M-F-Soares/5-CSRTT/Tela_Principal - Interface.jpg

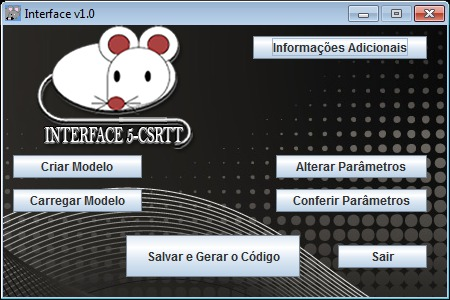
Tela_Principal - Interface.jpg
