M-F-Soares/5-CSRTT/Codex Atlanticus.JPG

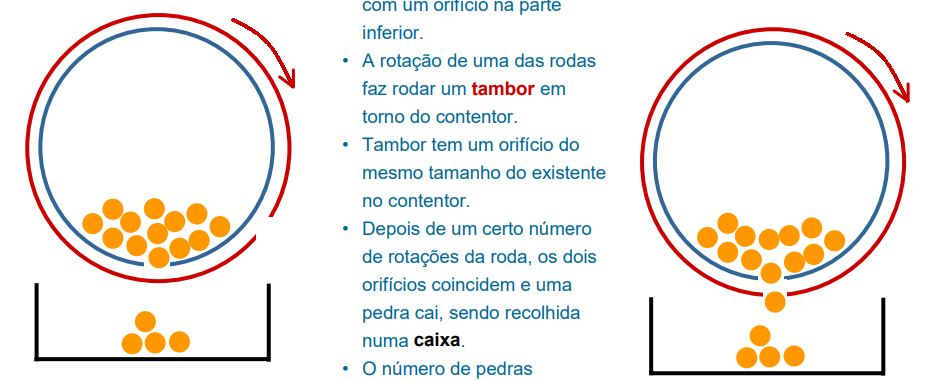
Codex Atlanticus.JPG
