M-F-Soares/5-CSRTT/5-choice essencial.pdf

# The application of the 5-choice serial reaction time task for the assessment of visual attentional processes and impulse control in rats

## Andrea Bari¹,2, Jeffrey W Dalley¹⁻³ & Trevor W Robbins¹,2

1Behavioural and Clinical Neuroscience Institute, University of Cambridge, Cambridge CB2 3EB, UK. 2Department of Experimental Psychology, University of Cambridge, Cambridge CB2 3EB, UK. 3Department of Psychiatry, University of Cambridge, Cambridge CB2 2QQ, UK. Correspondence should be addressed to T.W.R. (twr2@cam.ac.uk).

Published online 10 April 2008; doi:10.1038/nprot.2008.41

One popular way of measuring visual attentional processes in the rat is using 5-choice serial reaction time task (5-CSRTT). This paradigm requires subjects to detect brief flashes of light presented in a pseudorandom order in one of five spatial locations over a large number of trials. For this task, the animals are trained for B30–40 daily sessions during which they gradually learn to respond in the appropriate aperture within a certain amount of time. If they fail to respond, respond in the wrong hole or at an inappropriate time, a short period of darkness (time-out) is presented as punishment and no reward is delivered. The 5-CSRTT provides the possibility to test the effects of various neural, pharmacological and behavioral manipulations on discrete and somewhat independent measures of behavioral control, including accuracy of discrimination, impulsivity, perseverative responses and response latencies.

INTRODUCTION The 5-choice serial reaction time task (5-CSRTT) was initially developed to investigate and better understand the deficits shown by children with attention deficit/hyperactivity disorder (ADHD) at a preclinical level¹,2. The basic task is modeled after Leonard’s five-choice serial reaction task, which has been used to study human attentional processes³ and is considered to share many

components with the continuous performance test of attention⁴, also used in clinical settings.

The rat version of the task requires animals to detect brief flashes of light presented pseudorandomly in one of five holes and to make a nose-poke response in the correct spatial location in order to receive a food reward. To perform the task, the rat is required to monitor a horizontal array of apertures and to withhold from responding until the onset of the stimulus. Generally, the accuracy of stimulus discrimination provides an index of attentional capacity, while premature responses—made before the presentation of the stimulus—are regarded as a form of impulsive behavior and

hence a failure in impulse control¹.

### Attention is considered to be a heterogeneous construct in both

human and nonhuman subjects and the 5-CSRTT, in its basic form,

is well suited to assess animals’ deficits and/or improvements in sustained and spatially divided attention caused by pharmacological and neural manipulations. However, as we will see later, sensory and attentional demand of the basic task can be manipulated in several ways in order to characterize the neural and neurochemical substrates of attentional constructs under investigation¹,5. The 5-CSRTT has recently been used to assess trait impulsivity (in addition to attention) and this measure has been validated in part by its capacity to predict susceptibility to cocaine reinforcement⁶

and by its sensitivity to drugs used to treat human ADHD⁷⁻¹¹.

### The flexibility of the 5-CSRTT makes this task suitable for various testing purposes. For example, it is possible to test com-

pounds for the treatment of attentional deficits and impulsivity¹²;

### to assess attentional changes over the life span¹³,14 or those caused by chronic drug exposure¹⁵⁻¹⁷; to test the effects of discrete brain

lesions or neurotransmitter depletions¹⁸⁻²⁰; to select animals with specific patterns of behavior⁶,9 and to measure functional changes in neurotransmitter release or metabolic activity during the task (if coupled with the technique of in vivo microdialysis or 2-deoxyglucose autoradiography)²¹⁻²⁵. Moreover, the 5-CSRTT can be used to elucidate neuropsychological mechanisms that are disrupted in pathologies and states characterized by attentional dysfunctions such as childhood ADHD⁹, Alzheimer and Parkinson’s diseases²⁶,27, schizophrenia²⁸⁻³¹ and also aging¹³,14,32 and addiction¹⁵,16. The relationship with human research has been bidirectional, with animal work informing theories on the aetiology of human diseases and possible treatments, and human research

giving input to the design of preclinical investigations⁶,33–36.

The main strengths of the task are a high level of construct validity³⁷, a strict control over behavioral contingencies, accurate and automatized data acquisition and, due to its widespread use in many laboratories, it is of proven reliability. Some limitations are represented by the spatial and visual nature of the stimuli. Changes

in accuracy may reflect variations in visual sensory functions;

### however this problem can be addressed by varying the brightness of the visual discriminanda³⁸. In addition, the spatial component of

the task can be a confound in the interpretation of the results, but,

calculating the proportion of correct and incorrect responses made in each of the five spatial locations, it is possible to exclude subjects with a strong response bias¹⁹. Some other limitations are common to operant approaches in general. For example, it can be difficult to separate decrements in vigilance³⁹, which are typically evident toward the end of the session³⁷ (usually after an extended number of trials³²,40), from simple satiety due to the large number of pellets earned by the rat during the task. However, the latency to collect the

reward can help ruling out any decrement in motivation for food¹.

### On the other hand, food restriction itself constitutes a limitation to operant approaches and is a characteristic specific to research in animals. Prefeeding animals before testing is one approach that can be used to assess the effects of the general motivational state of the

animal on 5-CSRTT variables¹⁸,32.

### puor G

### gni hsil buP

### er ut a N8002 © natureprotocols / moc. er ut an. w

w
w//: ptt h
NATURE PROTOCOLS | VOL.3 NO.5 | 2008 | 759

# PROTOCOL

In summary, the 5-CSRTT has been used in a multitude of settings for a variety of research purposes, and this large amount of research has contributed substantially to our understanding of the neurobiological substrates and neurotransmitter systems underlying specific forms of attentional performance and behavioral

control¹,20,41–44.

### Most common applications of the paradigm Attentional processes are dysregulated in many psychiatric

disorders including ADHD⁴⁵, schizophrenia⁴⁶ and depression⁴⁷.

Optimal information processing in both humans and animals usually requires a mixture of sustained, divided and selective attention. Sustained attention (vigilance) is characterized by the continuous allocation of processing resources for the detection of rare events over an extended period of time⁴⁸. In the 5-CSRTT, long test sessions with high and low event rate (with short and long inter-trial interval (ITI), respectively) have previously been used to assess sustained visual attention⁴⁹. Moreover, the attentional load of the task can be manipulated by decreasing or increasing the

duration of the visual stimuli³².

The 5-CSRTT requires the animals to allocate their limited attentional resources on different sensory channels and spatial locations (spatially divided attention) in order to achieve an optimal level of performance. Moreover, as we will see later, one of the several modifications of the basic task structure allows to test also selective (focused) attention by interpolating irrelevant and distracting stimuli (most commonly in the auditory modality) during the ITI, while the animal has to attend to the occurrence of the target visual stimuli. In addition to attentional deficits, another symptom characteristic of ADHD and of many other psychiatric conditions is impulsivity, which is also a nonunitary construct⁵⁰ and can be defined as the tendency to act without foresight or before all the necessary information has been collected. The 5-CSRTT assesses the ability of the animal to wait for the occurrence of the visual stimulus and thus to withhold an impulsive response to one of the apertures. The flexibility of the task allows the experimenter to systematically manipulate the exact timing of

the occurrence of the stimuli so to make the waiting period short,

long or unpredictable⁵¹. The unpredictability of the stimuli makes the task more difficult because the animal cannot rely on automatic processes when orienting to the visual discriminanda, but has to continuously sustain response readiness¹ (see ANTICIPATED RESULTS for examples of results obtained after different task

manipulations).

Experimental design The protocol described in the following sections represents the most widely adopted task configuration implemented in the nine-hole box (see EQUIPMENT SETUP) in studies of attentional processes²,38. The nine-hole box can be configured for use in a wide range of applications such as delayed matching to position (‘working memory’), discrimination learning and cued target detection³⁸,52–54. Operant chambers equipped with only five aper-

tures are also available from various commercial vendors.

Here we will refer to the 5-CSRTT configuration of the apparatus, and relative parameter manipulations, that we use in our laboratory with adult Lister hooded rats. However, this protocol can also be used with different strains of rats after adjusting training length, baseline criteria and task parameters according to the visual capacity and cognitive skills of the animals³⁶. Slightly different

versions of the task exist for mice⁵⁵, monkeys⁵⁶,57 and humans¹³,35.

### Moreover, among the same strain of animals, the 5-CSRTT has been used to divide subjects according to good or bad performance based on parameters such as premature responses or choice

accuracy⁶,8,25,58.

In the most widely adopted version of the task (see Fig. 1), each post-training session begins with the illumination of the house light and of the food magazine where a ‘free’ food pellet is delivered. The rat initiates a trial by nose-poking in the food magazine to collect the pellet. Then, the light in the food magazine is extinguished and an ITI (standard: 5 s) starts during which the rat is required to sustain visual spatial attention (scanning behavior) to the five apertures present in the front panel of the operant chamber. At the end of the ITI, a brief visual stimulus (standard: 0.5 s) is presented in a random location and the animal is required to nose-poke in the hole where the stimulus appeared within a limited period (limited hold, LH; usually 5 s). The choice of the rat is detected by IR photocell beams located near the entrance of each aperture. A correct choice is rewarded with a food pellet delivered in the magazine (concurrently with its illumination) located in the opposite wall of the chamber, where an additional photocell beam

records the latency of food collection and starts the next ITI.

Response errors are represented by the number of omissions (i.e., failure to respond to the stimulus within the LH), errors of commission (i.e., responses made to the wrong location) and premature responses (i.e., responses made before the presentation of the visual stimulus in any of the five apertures; i.e., during the

### puor G

### gni hsil buP

### er ut a N8002 © natureprotocols / moc. er ut an. w

w
w//: ptt h

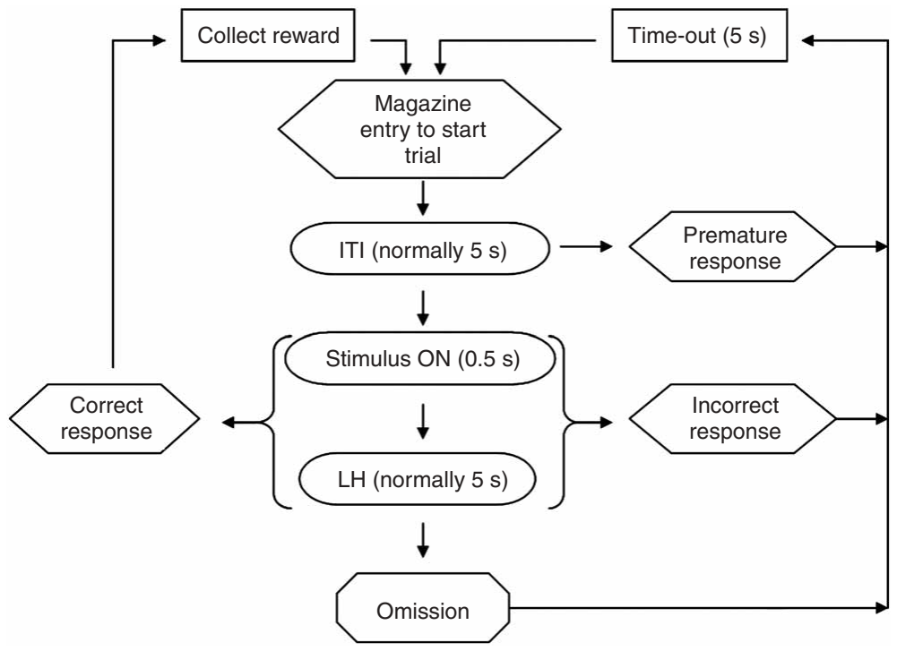
[picture p3: figure]
Collect reward; Time-out (5 s); Magazine entry to start trial; ITI (normally 5 s); Premature; response; Incorrect response; Stimulus ON (0.5 s); LH (normally 5 s); Omission; Correct response

Figure 1 | Possible trial sequences of the 5-choice serial reaction time task.
A trial is initiated by the rat entering the food magazine. A brief light stimulus is then presented in one of five possible apertures after a 5-s inter-trial interval (ITI) has elapsed. Rats are required to scan the five apertures for the appearance of the light stimulus and to respond in the ‘correct’ aperture with a nose-poke response in order to earn a single food pellet. If the rat responds before the stimulus (‘premature response’) or in an adjacent incorrect aperture (‘incorrect response’), a 5-s time-out (TO) period is introduced where the house light is extinguished and no food reward is provided. A failure to respond within the limited hold (LH) period results in an ‘omission’ and a subsequent 5-s TO period. After collecting the reward or—on punished trials—at the end of the TO period, a head entry in the food magazine starts a new trial.
760 | VOL.3 NO.5 | 2008 | NATURE PROTOCOLS

ITI). Inappropriate responses such as these are punished with a 5-s period of darkness (time-out, TO) during which no food is delivered and no action can be performed. TO periods are specifically used to suppress inappropriate behavior and thus signal to the animal the sequence of actions needed to obtain food reward. After a TO, the food magazine and the house light are illuminated and the rat has to nose-poke in the food magazine to

start a new trial.

Variables measured include both accuracy levels and response times (see DATA ANALYSIS). The accuracy in detecting the light stimulus and thus responding to the right locations is usually expressed as percentage of the total number of correct and incorrect responses, and does not include errors of omission or premature responses. Since the visual stimuli are presented the same number of times in each of the five apertures, the chance level of performance is 20%. However, further analysis can take into account also the spatial distribution of incorrect responses for each trial relatively to the correct location¹⁹,59. Additional responses in any of the five holes or in the food magazine are recorded as perseverative, which is often interpreted as a form of compulsive behavior¹. This parameter, together with the measure of premature responses (made during the ITI period), provides an index of

inhibitory response control. In previous experiments in our lab,

### perseverative responses resulted in a 5 s TO that was restarted every

### time the rat made a further response during the TO period (cumulative TO). However, we no longer punish perseverative responses

because of the significant disruptive effect this has on training.

To assess the speed of responding, three response times, or latencies, are usually measured. These are the mean latency to respond correctly (i.e., time elapsed between the onset of the stimulus and a response in the correct aperture), the mean latency of responses made in the wrong location, and the mean latency to collect the reward in the food magazine (i.e., the period between a

correct response and a head entry in the food magazine).

### Additionally, the latency of premature responses can be measured separately and the time distribution of correct, incorrect and premature responses can be analyzed further by dividing the LH

period into several time bins¹⁹.

### Response times in this task are valuable indices of the speed of information processing, readiness, decision making and general motivation of the animal. However, for a more accurate interpretation of these measures, it is useful to take into account the pattern

of changes in other variables¹.
Following the training schedule described in the later sections,

### animals generally reach a stable level of performance within 35 daily sessions. A good level of baseline performance is represented by accurate stimulus detection (i.e., 480% accuracy) and low levels of

omissions (i.e., o20%).

### MATERIALS

REAGENTS
.Rats (see REAGENT SETUP)
.Standard laboratory rodent food pellets (e.g., Purina Rat Chow)
.Food reward pellets (e.g., TestDiet 45 mg precision-weight, purified

ingredient rodent tablets; Sandown Scientific)
.Surface disinfectant for cleaning (e.g., Trigene or 70% ethanol solution) .Animal housing (see REAGENT SETUP)

EQUIPMENT
.Rat 9-hole (or 5-hole) operant chambers (e.g., Coulbourn Instruments,

Med Associates or other commercial suppliers; or custom-made 5-choice operant boxes)
.Sound-attenuating, fan-ventilated cubicles (large enough to enclose each

operant chamber and pellet dispenser)
.Dedicated computer software (see EQUIPMENT SETUP)
.Hardware to interface the operant boxes (interfacing hardware is generally

available from the suppliers of the operant boxes)
.Uninterruptible power supply (UPS)
.Data handling software (database for large amount of data; e.g.,

Microsoft Access)
.Data analysis software (e.g., SPSS)
.Medical gloves (e.g., nitrile or latex) and appropriate personal protection

equipment (e.g., lab coat and FFP2D type mask)
.Micro-camera connected to a closed circuit monitor (optional) .Controlling devices (see EQUIPMENT SETUP)

REAGENT SETUP
Rats Commercially available or laboratory-bred rats are commonly
used in the 5-CSRTT; although the task can be adapted for use in mice⁶⁰,61, the specific protocol and apparatus have been described elsewhere⁵⁵. In our laboratory we routinely use adult male Lister hooded rats, but the task is also suitable for use with adolescent⁶², aged¹⁴,40, female⁶³ or other strains of rats⁶⁴,65. ! CAUTION All experiments involving live animals must be approved by, and performed according to, national and institutional regulations.
Animal housing House rats in pairs or in groups of four per cage with sawdust on the bottom in a room maintained at a constant ambient temperature (20–24 1C) and humidity (55–70%). If the animals are purchased from a commercial vendor or have been shipped from any external location, they should be allowed to acclimatize to the new housing room for at least 7 d. During this period, provide food pellets and drinking water ad libitum and leave the animals undisturbed. In our laboratory we use a reverse light–dark cycle (lights on: 19:00 to 7:00 h) in order to test the rats during the most active period of their circadian cycle.
EQUIPMENT SETUP
Rat 9-hole (or 5-hole) operant chambers The 9- and 5-hole boxes present slightly different characteristics depending on the supplier and the actual model. The main features of the first models used in our laboratory have been described elsewhere². Usually the apparatus (25 25 25 cm³) consists of two aluminum walls, one of which is curved and equipped with 9 or 5 square holes of 2.5 cm sides, 4 cm deep and positioned 2 cm above the grid floor. The opposite aluminum wall is not curved and is equipped with a food well
(5 5 cm²) connected to a pellet dispenser (positioned outside the box) through a semi-transparent plastic tube. All the square holes and the food tray have IR beams crossing their entrance in order to detect the animals’ responses. The food tray and each hole are illuminated independently according to the task contingencies. The holes are usually numbered from 1 to 9 (or from 1 to 5) and they could be closed with metal or plastic caps, while the food tray may be fitted, in some models, with a plastic panel connected to a micro-switch that substitutes the IR beams in detecting head entries of the animal. The distance of the food tray is 25 cm for each hole on the curved wall
(see Fig. 2). Optionally, a loudspeaker could be fitted on the roof, or on the flat wall just below the house light (usually 3 W), which is the main source of illumination of the box during the task. The two side walls are made of clear polycarbonate or metal panels, one of which has a hinged door to allow the introduction of the animal. The floor is usually a metallic grid and the roof is made of clear polycarbonate or metal, sometimes with a small opening to allow the connection with external equipment (e.g., through perfusion tubing or electrical cables). Each box is accommodated within a sound-attenuating cubicle, which is ventilated by a fan that also provides a low background level of noise (see Fig. 3). Additionally, a micro-camera
could be mounted on the ceiling of the sound-attenuating cubicle in order to monitor rats’ behavior.
m CRITICAL Operant chambers should be cleaned and inspected regularly in order to avoid equipment malfunction and residue accumulation. Moreover, spare parts should be kept for each critical component of the apparatus (see TROUBLESHOOTING).
Controlling devices The task contingencies are usually controlled by a personal computer powered through an UPS device and connected to

### puor G

### gni hsil buP

### er ut a N8002 © natureprotocols / moc. er ut an. w

w
w//: ptt h

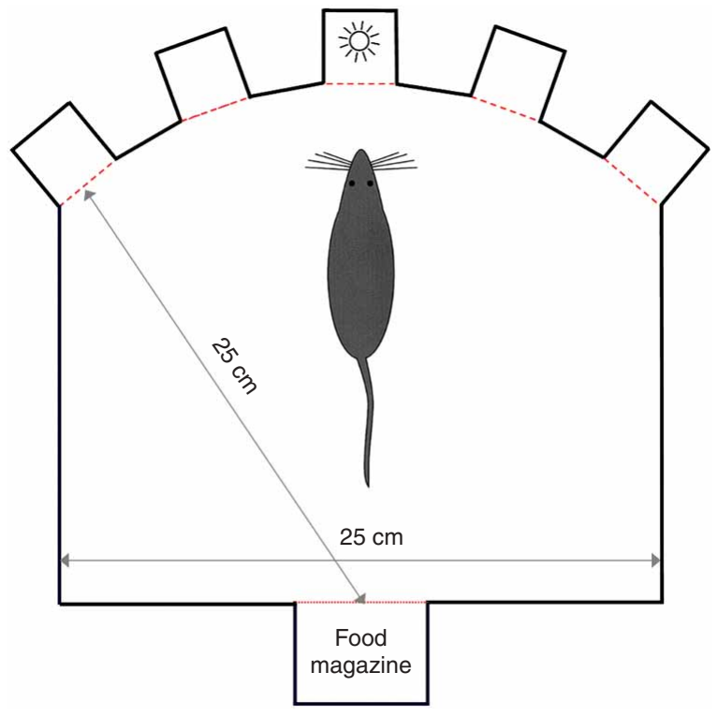
[picture p4: figure]
Food magazine

interfacing hardware through industry standard architecture (ISA) or peripheral component interface (PCI) slots. This hardware allows to interface the output and input data lines of the operant chambers to the personal computer. Although the interfacing hardware could be provided by the vendors of the operant chambers, digital input/output boards can also be purchased separately (e.g., Amplicon 272 series or Avantech 1753 cards). The operant chambers should be controlled by a computer having at least the minimum speed and memory requirements in order to present the stimuli and collect behavioral responses without any appreciable delay.
In our laboratory we use ‘Whisker server’⁶⁶ software to control inputs and outputs of the operant chambers. This software is commercially available and includes the 5-CSRTT client in its software suite. Alternative software to control the operant chambers can also be obtained from other sources (e.g., Med Associates, Campden Instruments, Lafayette Instruments), downloaded from the internet (e.g., http://www.mednr.com/programs/5csrtt.htm) or can be written using common programming languages.

## PROCEDURE Initial habituation 1| Gradually restrict (e.g., over 3 d) the daily amount of

food for each rat to B5 g of food per 100 g body weight.

## 2| Weigh each rat daily from the first day of food restriction

until they reach B85–90% of their free-feeding weight. Then,
weigh animals regularly (e.g., weekly) to monitor their growth.
! CAUTION Ensure that the body weight does not fall below 85% of the normal growth curve, which can usually be found on the website of the animals’ supplier. Alternatively, where appropriate, compare the weight of food-restricted animals with that of nonrestricted animals in order to determine precisely the extent of weight loss in individual animals.

3| Gradually habituate the animals to the experimenter over at least 3 d by gently handling each rat for 2–3 min d-

## 1, starting

on the first day of food restriction.
! CAUTION It is advisable to use disposable medical gloves always and to wear appropriate personal protection equipment when handling animals in order to minimize allergen-induced sensitization.

4| Every day, after handling, put some reward pellets (e.g., TestDiet 45 mg pellets) inside the cage (B30 per rat) to habituate the animals to their taste and to avoid hyponeophagia.

5| Devise a tail-marking system and assign a unique identification number to each animal. Use a nontoxic, odorless, permanent marker. Repeat this operation regularly to avoid fading of the marks. Although we prefer this method for identifying each animal, other techniques can also be used (e.g., ear tag, subcutaneous microchip).
m CRITICAL STEP Avoid marking the tail of the animal immediately before a critical experimental test session.

## Habituation to testing apparatus

6| Place ten reward pellets in the food tray and two pellets in each of the five apertures for each operant box.

7| Bring the rats to the testing room, assign each rat to a single operant box and start a short session (e.g., 15–20 min) during which all five stimulus lights, the house light and the tray light remain illuminated throughout the session. Repeat this step until the rats reliably eat all the pellets provided.

### puor G

### gni hsil buP

### er ut a N8002 © natureprotocols / moc. er ut an. w

w
w//: ptt h
Figure 2 | Schematic diagram of the 5-choice serial reaction time task
chamber showing the spatial arrangement of the five response apertures in relation to the food magazine. (Reprinted from ref. 72 with permission from Elsevier).

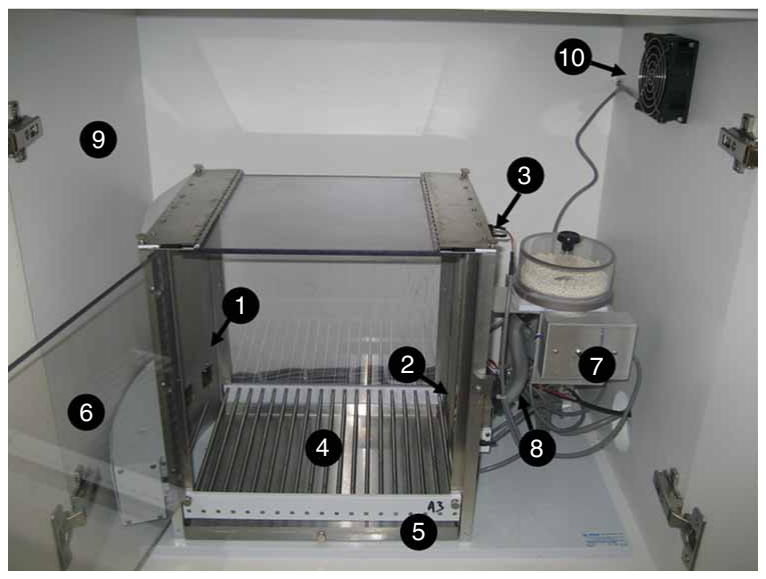
[picture p5: figure]

Figure 3 | Principal components of the 5-choice serial reaction time task
apparatus (commercial supplier: Med Associates, St. Albans, VT). On the front wall of the chamber (1) are five square holes equipped with IR detectors. IR photo beams are also present inside the food magazine (2) fitted on the opposite wall, where the house light is located (3). The floor of the chamber
(4) consists of stainless steel rods and at the bottom there is a removable tray (5). The hinged door (6) is generally made of transparent polycarbonate. The pellet dispenser (7) is located outside of the box and automatically delivers food pellet to the magazine through a plastic tube (8). The apparatus is enclosed within a sound-attenuating cubicle (9) fitted with an electric fan (10), which provides ventilation and low background noise.

m CRITICAL STEP Always adjust the amount of standard laboratory pellets you give daily to the rats subtracting the amount of reward pellets they eat during the session (e.g., for a B300-g rat: 15 g of standard pellets – (20 45 mg reward pellets) ¼ B14 g of standard pellets per rat after the training).
m CRITICAL STEP The time at which the animals are trained, tested and fed should be kept constant throughout
the experiment.

## 5-CSRTT training

8| Once the rats are habituated to the testing apparatus and to the reward pellets, start the 5-CSRTT training. No pellets should be placed in the holes or magazine during this phase of the training. Set up the software configuration for each box (see Experimental design and Fig. 1). Training sessions will generally comprise 100 trials and last B30 min. On each trial, only one hole is illuminated and the sequence is implemented by the computer software according to a pseudorandom schedule. In this way, each hole is illuminated 20 times during a 100 trials session. The appropriate initial parameters (see Table 1; stage 1) are: stimulus duration, 30 s; ITI, 2 s; LH, 30 s; TO, 5 s.

## Note: The majority of the rats begin to respond within four to

five sessions.

## m CRITICAL STEP Train and test the rats always in the same operant box because even a small change in the environment can

have deleterious effects on the training.

## 9| Once the animals reach a criterion of at least 30 correct trials, gradually decrease the stimulus duration and increase the ITI until the ‘target parameters’ are attained (see Table 1

and Supplementary Video 1 online).

10| To train the animals as described in Table 1 and to reach the ‘target parameters’, it usually requires B25 sessions during which the accuracy gradually increases. To achieve stable performance, train the animals for a further six to ten sessions until individual rats show reliably stable performance across days (Z80% accuracy and r20% of omissions). Depending on experimental objectives, animals that fail to achieve these criteria may be excluded as outliers or retained to assess important variations in the performance of poor-performer animals (e.g., premature responses, choice

accuracy)⁶,9,67.

## Post-training experimental manipulations

11| Once the performance is stable for at least six sessions,

use the data from the last 4 d of training to provide a baseline index of performance. Divide the subjects into two or more groups, matched for baseline performance, depending on the number of experimental manipulations (e.g., lesion sites, drug doses). Alternatively, animals may serve as their own controls, for example, using a within subjects design in pharmacological drug studies. Here it is important to control for the order of dosing using a randomized Latin

square design.

12| Depending on the aims of the experiment and the hypotheses under investigation, different manipulations of the basic task can be implemented during post-training sessions in order to vary task demands. We will describe the most commonly used variations of the basic task in which the standard settings are represented by the ‘target parameters’ of Table 1: short stimulus duration (option A); variable short and long ITI (option B); brightness of the visual signal (option C); and distracting noise (option D). These manipulations can be

### puor G

### gni hsil buP

### er ut a N8002 © natureprotocols / moc. er ut an. w

w
w//: ptt h
TABLE 1 | 5-CSRTT training schedule.

### Training stage

### Stimulus duration (s) ITI (s) LH (s)

### Criterion to move to next stage

1 | 30 | 2 | 30 | Z30 Correct trials
2 | 20 | 2 | 20 | Z30 Correct trials
3 | 10 | 5 | 10 | Z50 Correct trials
4 | 5 | 5 | 5 | Z50 Correct trials
| | | | 480% Accuracy
| | | | Z50 Correct trials
5 | 2.5 | 5 | 5 | 480% Accuracy
| | | | o20% Omissions
| | | | Z50 Correct trials
6 | 1.25 | 5 | 5 | 480% Accuracy
| | | | o20% Omissions
| | | | Z50 Correct trials
7 | 1 | 5 | 5 | 480% Accuracy
| | | | o20% Omissions
| | | | Z50 Correct trials
8 | 0.9 | 5 | 5 | 480% Accuracy
| | | | o20% Omissions
| | | | Z50 Correct trials
9 | 0.8 | 5 | 5 | 480% Accuracy
| | | | o20% Omissions
| | | | Z50 Correct trials
10 | 0.7 | 5 | 5 | 480% Accuracy
| | | | o20% Omissions
| | | | Z50 Correct trials
11 | 0.6 | 5 | 5 | 480% Accuracy
| | | | o20% Omissions
| | | | Z50 Correct trials
12 Target | 0.5 | 5 | 5 | 480% Accuracy
parameters | | | | o20% Omissions

Overview of the steps involved in training rats on the 5-choice serial reaction time task (5-CSRTT). Following habituation to the chamber, training proceeds via 12 distinct criterion-based stages. ITI, inter-trial interval; LH, limited hold.

made within a single ‘challenge’ session and/or repeated over several days. In this latter case, be sure to interpose ‘control’ sessions (usually one or two), with standard parameters, to enable the reattainment of stable performance³⁸. Moreover, although we will refer to commonly used methods for which relevant literature is available, optimal experimental design (e.g., within or between sessions design) is determined by the objectives and requirements of the specific experiment.

## (A) Short stimulus duration

(i) Set the stimulus duration to be shorter than the standard one (e.g., 0.25 or 0.125 s) and run a single session
for each rat⁵,68.
(ii) Alternatively, test a range of different stimulus lengths (e.g., 0, 0.01, 0.1, 0.2, 0.5 s) in a randomized order across sessions and subjects or within the same session¹³.
m CRITICAL STEP Since animals readily adapt to this manipulation, it is important to space repeated presentations
by at least 4 d.
m CRITICAL STEP It is possible in some circumstances to restore impaired performance by lengthening the stimulus duration. This procedure could be useful for bringing two experimental groups of subjects to similar levels of performance in order to assess the effects of other task manipulations against similar levels of accuracy⁶⁹,70.

## (B) Variable short and long ITI

(i) Within a single session, set a range of ‘short’ ITIs (e.g., four different values 0.5, 1.5, 3.0 and 4.5 s). Make sure to present each ITI length for the same number of trials for each spatial location²⁰.
(ii) After one or two baseline sessions, set a range of ‘long’ ITIs (e.g., 4.5, 6.0, 7.5, 9.0 s) and proceed as in Step 12B(i)¹⁸.
m CRITICAL STEP When using a long ITI challenge it is advisable to increase the maximum session duration (e.g., from 30 to 45 min) in order to allow sufficient time for subjects to complete all of the trials²⁰.

## (C)Brightness of the visual stimuli

(i) To check for differences in visual sensory functions between two experimental groups, set the intensity of the
visual stimuli to different levels of intensity (e.g., three different levels, all of which are fractions of the standard one). This manipulation is normally achieved by increasing the resistance in the electric circuit controlling the stimulus lights²,38,71.
(ii) Present each brightness condition within one session (including the standard stimulus intensity) keeping all the other parameters at standard values²,18.
m CRITICAL STEP Make sure that all of the five light stimuli have equal light intensities by measuring them with a commercially available instrument.
m CRITICAL STEP Increase the number of trials, if necessary, in order to present the different conditions an adequate number of times.

## (D) Distracting noise

(i) To assess the capacity of the animals to focus attentional processes toward the relevant stimuli, run a standard session interpolating brief bursts of white noise (0.5 s, 4100 dB) at various points within the normal ITI (e.g., 0.5, 2.5, 4.5, 5 s after the beginning of the ITI period)¹⁸,70.
(ii) Present the different conditions of the white noise the same number of times and in a randomized order for each spatial location.
m CRITICAL STEP In order to present each condition (delays) of the distracting stimuli for each spatial location for an adequate number of trials, it is advisable to increase the total number of trials in the session. Moreover, a certain number of control trials (in which no distracting noise is presented, e.g., 20% of trials) should be included².
m CRITICAL STEP Make sure that the distracting noise intensity is the same for each operant box measuring it with a commercially available device.
m CRITICAL STEP Avoid using this manipulation repeatedly because the animals will habituate to the distracting noise after repeated exposure.

## Data analysis 13| Record the following main behavioral variables for each subject on the 5-CSRTT:

Accuracy of discriminative performance, calculated as the number of correct responses divided by the total number of correct and incorrect responses expressed as a percentage.
Number of premature responses, defined as the number of anticipatory responses made before the onset of the visual stimulus in each session. In the most common version of the 5-CSRTT only one premature response is recorded on each trial.
Number of correct, incorrect and omitted trials in a session.
Latency to respond in a hole following the onset of the visual stimulus (for correct and incorrect responses separately).
Latency to collect food reward in the magazine following a correct response.
Number of repeat (or perseverative) nose-pokes either in the same hole as the target stimulus or in a different hole. Number of perseverative head entries in the magazine following food delivery.

### puor G

### gni hsil buP

### er ut a N8002 © natureprotocols / moc. er ut an. w

w
w//: ptt h

## ? TROUBLESHOOTING

## TIMING

## Steps 1–5, 5 min per rat per day: 5–6 d Steps 6 and 7, 25–30 min per rat per day: 1–2 d Steps 8–10, 20–40 min per rat per day: B30 d

## ? TROUBLESHOOTING

Troubleshooting advice can be found in Table 2. Some components of the operant chambers are more likely to fail after repeated use than others. It is good practice to have spare light bulbs, IR beams and pellet dispenser always available. Moreover, it is extremely important that regular checks are made on the operation of each test chamber. This should be done on a twice weekly basis to ensure that IR beams, light stimuli and the pellet dispensers are functioning reliably.

## ANTICIPATED RESULTS

Table 3 shows the effects of various behavioral manipulations on the baseline performance of a group of well-trained male Lister hooded rats on the 5-CSRTT (J.W.D., A.B. and T.W.R., unpublished data). It can be seen that reducing the stimulus duration from 0.5 to 0.125 s decreases the accuracy of responding by B20%. When the stimuli are made temporally, as well as

### puor G

### gni hsil buP

### er ut a N8002 © natureprotocols / moc. er ut an. w

w
w//: ptt h
TABLE 2 | Troubleshooting table.
Problem | Possible reason | Solution
Animal stops responding | Pellet dispenser may be jammed | Check the pellet dispenser and clean any blockage in the tube connecting the dispenser with the magazine
| Photo beam(s) failure | Clean photo beam(s) with a moistened cotton bud
| Light bulb(s) failure | Change faulty light bulb(s)
| Interface failure | Check for possible faulty line(s) in the input/output interface
Unstable performance or an abrupt decline in performance | Excessive satiety/hunger | Ensure that animals have been adequately fed
| | Feed animals after each training or test session at roughly the same time each day
Uneven performance across different operant boxes | Different intensity of the visual and/or acoustic stimuli | Titrate the intensity of visual and auditory stimuli to a uniform level
| Unreliable pellet delivery | Ensure that pellet dispensers are functioning reliably
Excessive perseverative responses | Photo beam(s) failure | Clean photo beams (as above)
Low discriminative accuracy | House light intensity too high | Replace the house light bulb
| Visual stimuli too dim | Increase the brightness of the visual stimuli
TABLE 3 | Expected baseline performance of adult male Lister hooded rats on the 5-choice serial reaction time task (n ¼ 9, mean ± s.e.m.).
| Baseline | Reduced SD | Var ITI | HER | White noise
Accuracy (%) | 80.7 ± 2.8 | 59.0 ± 3.1** | 79.4 ± 1.5 | 67.6 ± 2.0** | 86.3 ± 1.9
Omissions (number) | 5.8 ± 1.6 | 15.3 ± 4.7* | 11.9 ± 1.9** | 21.8 ± 2.8** | 7.1 ± 1.5
Response latency (ms) | 571 ± 41 | 598 ± 41 | 554 ± 31 | 863 ± 69** | 478 ± 23*
Premature responses | 6.6 ± 1.1 | 10.3 ± 1.4* | 32.4 ± 2.0** | 0.7 ± 0.4** | 15.5 ± 2.9*

HER, high event rate (inter-trial interval (ITI) ¼ 2 s); SD, stimulus duration; var, variable. *P o 0.05; **P o 0.01 (compared to baseline condition).

spatially, unpredictable (variable ITI 2, 4, 6 and 8 s) the main effect is to increase the number of premature responses. By contrast, when the target stimuli are presented with high frequency (high event rate; HER) over a large number of trials—in this case 200—detrimental effects on performance are normally observed, including a reduction in accuracy, an increase in omissions and a slowing of response latency. The number of premature responses also decreases under a HER manipulation. The presentation of a brief auditory stimulus (105 dB) during the ITI has the effect of increasing premature responding, especially when the auditory distractor is presented immediately prior to the onset of the visual target stimulus².

Note: Supplementary information is available via the HTML version of this article.

ACKNOWLEDGMENTS This research was supported by a Wellcome Trust programme grant (076274/z/04/z) and completed within the Cambridge University Behavioural and Clinical Neuroscience Institute, supported by a joint award from the Medical Research Council (MRC) and Wellcome Trust. A.B. was supported by an MRC studentship. The authors thank Dr Y. Pelloux and Mr D.E. Theobald for assistance.

COMPETING INTERESTS STATEMENT The authors declare competing financial interests (see the HTML version of this article for details).

Published online at http://www.natureprotocols.com
Reprints and permissions information is available online at http://npg.nature.com/reprintsandpermissions
1. Robbins, T.W. The 5-choice serial reaction time task: behavioural pharmacology and functional neurochemistry. Psychopharmacology (Berl.) 163, 362–380 (2002).
2. Carli, M., Robbins, T.W., Evenden, J.L. & Everitt, B.J. Effects of lesions to ascending noradrenergic neurones on performance of a 5-choice serial reaction task in rats; implications for theories of dorsal noradrenergic bundle function based on selective attention and arousal. Behav. Brain Res. 9, 361–380 (1983).
3. Wilkinson, R.T. Interaction of noise with knowledge of results and sleep deprivation. J. Exp. Psychol. 66, 332–337 (1963).
4. Beck, L.H., Bransome, E.D. Jr., Mirsky, A.F., Rosvold, H.E. & Sarason, I. A continuous performance test of brain damage. J. Consult. Psychol. 20, 343–350 (1956).
5. Hahn, B., Shoaib, M. & Stolerman, I.P. Nicotine-induced enhancement of attention in the five-choice serial reaction time task: the influence of task demands. Psychopharmacology (Berl.) 162, 129–137 (2002).
6. Dalley, J.W. et al. Nucleus accumbens D2/3 receptors predict trait impulsivity and cocaine reinforcement. Science 315, 1267–1270 (2007).
7. Navarra, R. et al. Effects of atomoxetine and methylphenidate on attention and impulsivity in the 5-choice serial reaction time test. Prog. Neuropsychopharmacol. Biol. Psychiatry 32, 34–41 (2008).
8. Blondeau, C. & Dellu-Hagedorn, F. Dimensional analysis of ADHD subtypes in rats. Biol. Psychiatry 61, 1340–1350 (2007).
9. Puumala, T. et al. Behavioral and pharmacological studies on the validation of a new animal model for attention deficit hyperactivity disorder. Neurobiol. Learn. Mem. 66, 198–211 (1996).
10. Bizarro, L., Patel, S., Murtagh, C. & Stolerman, I.P. Differential effects of psychomotor stimulants on attentional performance in rats: nicotine, amphetamine, caffeine and methylphenidate. Behav. Pharmacol. 15, 195–206 (2004).
11. Robinson, E.S. et al. Similar effects of the selective noradrenaline reuptake inhibitor atomoxetine on three distinct forms of impulsivity in the rat. Neuropsychopharmacology 33, 1028–1037 (2008).
12. Day, M. et al. Differential effects of ciproxifan and nicotine on impulsivity and attention measures in the 5-choice serial reaction time test. Biochem. Pharmacol. 73, 1123–1134 (2007).
13. Jones, D.N., Barnes, J.C., Kirkby, D.L. & Higgins, G.A. Age-associated impairments in a test of attention: evidence for involvement of cholinergic systems.
J. Neurosci. 15, 7282–7292 (1995).
14. Muir, J.L., Fischer, W. & Bjorklund, A. Decline in visual attention and spatial memory in aged rats. Neurobiol. Aging 20, 605–615 (1999).
15. Dalley, J.W. et al. Cognitive sequelae of intravenous amphetamine self-administration in rats: evidence for selective effects on attentional performance. Neuropsychopharmacology 30, 525–537 (2005).
16. Dalley, J.W. et al. Attentional and motivational deficits in rats withdrawn from intravenous self-administration of cocaine or heroin. Psychopharmacology (Berl.) 182, 579–587 (2005).
17. Dalley, J.W. et al. Enduring deficits in sustained visual attention during withdrawal of intravenous methylenedioxymethamphetamine self-administration in rats: results from a comparative study with d-amphetamine and methamphetamine. Neuropsychopharmacology 32, 1195–1206 (2007).
18. Harrison, A.A., Everitt, B.J. & Robbins, T.W. Central 5-HT depletion enhances impulsive responding without affecting the accuracy of attentional performance: interactions with dopaminergic mechanisms. Psychopharmacology (Berl.) 133, 329–342 (1997).
19. Passetti, F., Chudasama, Y. & Robbins, T.W. The frontal cortex of the rat and visual attentional performance: dissociable functions of distinct medial prefrontal subregions. Cereb. Cortex 12, 1254–1268 (2002).
20. Chudasama, Y. et al. Dissociable aspects of performance on the 5-choice serial reaction time task following lesions of the dorsal anterior cingulate, infralimbic and orbitofrontal cortex in the rat: differential effects on selectivity, impulsivity and compulsivity. Behav. Brain Res. 146, 105–119 (2003).
21. Winstanley, C.A., Theobald, D.E., Dalley, J.W., Cardinal, R.N. & Robbins, T.W. Double dissociation between serotonergic and dopaminergic modulation of medial prefrontal and orbitofrontal cortex during a test of impulsive choice. Cereb. Cortex 16, 106–114 (2006).
22. Dalley, J.W. et al. Distinct changes in cortical acetylcholine and noradrenaline efflux during contingent and noncontingent performance of a visual attentional task. J. Neurosci. 21, 4908–4914 (2001).
23. Passetti, F., Dalley, J.W., O’Connell, M.T., Everitt, B.J. & Robbins, T.W. Increased acetylcholine release in the rat medial prefrontal cortex during performance of a visual attentional task. Eur. J. Neurosci. 12, 3051–3058 (2000).
24. Dalley, J.W., Theobald, D.E., Pereira, E.A., Li, P.M. & Robbins, T.W. Specific abnormalities in serotonin release in the prefrontal cortex of isolation-reared rats measured during behavioural performance of a task assessing visuospatial attention and impulsivity. Psychopharmacology (Berl.) 164, 329–340
(2002).
25. Barbelivien, A., Ruotsalainen, S. & Sirvio, J. Metabolic alterations in the prefrontal and cingulate cortices are related to behavioral deficits in a rodent model of attention-deficit hyperactivity disorder. Cereb. Cortex 11, 1056–1063 (2001).
26. Carli, M., Evenden, J.L. & Robbins, T.W. Depletion of unilateral striatal dopamine impairs initiation of contralateral actions and not sensory attention. Nature 313, 679–682 (1985).
27. Muir, J.L., Dunnett, S.B., Robbins, T.W. & Everitt, B.J. Attentional functions of the forebrain cholinergic systems: effects of intraventricular hemicholinium, physostigmine, basal forebrain lesions and intracortical grafts on a multiplechoice serial reaction time task. Exp. Brain Res. 89, 611–622 (1992).
28. Chudasama, Y. & Robbins, T.W. Psychopharmacological approaches to modulating attention in the five-choice serial reaction time task: implications for schizophrenia. Psychopharmacology (Berl.) 174, 86–98 (2004).
29. Amitai, N., Semenova, S. & Markou, A. Cognitive-disruptive effects of the psychotomimetic phencyclidine and attenuation by atypical antipsychotic medications in rats. Psychopharmacology (Berl.) 193, 521–537 (2007).
30. Le Pen, G., Grottick, A.J., Higgins, G.A. & Moreau, J.L. Phencyclidine exacerbates attentional deficits in a neurodevelopmental rat model of schizophrenia. Neuropsychopharmacology 28, 1799–1809 (2003).
31. Baviera, M., Invernizzi, R.W. & Carli, M. Haloperidol and clozapine have dissociable effects in a model of attentional performance deficits induced by blockade of NMDA receptors in the mPFC. Psychopharmacology (Berl.) 196, 269–280 (2007).
32. Grottick, A.J. & Higgins, G.A. Assessing a vigilance decrement in aged rats: effects of pre-feeding, task manipulation, and psychostimulants. Psychopharmacology (Berl.) 164, 33–41 (2002).
33. Winstanley, C.A., Eagle, D.M. & Robbins, T.W. Behavioural models of impulsivity in relation to ADHD: translation between clinical and preclinical studies. Clin. Psychol. Rev. 26, 379–395 (2006).
34. Chudasama, Y. & Robbins, T.W. Functions of frontostriatal systems in cognition: comparative neuropsychopharmacological studies in rats, monkeys and humans. Biol. Psychol. 73, 19–38 (2006).

### puor G

### gni hsil buP

### er ut a N8002 © natureprotocols / moc. er ut an. w

w
w//: ptt h

35. Sahakian, B.J. et al. Further analysis of the cognitive effects of tetrahydroaminoacridine (THA) in Alzheimer’s disease: assessment of attentional and mnemonic function using CANTAB. Psychopharmacology (Berl.) 110, 395–401 (1993).
36. Paine, T.A., Tomasiewicz, H.C., Zhang, K. & Carlezon, W.A. Jr. Sensitivity of the five-choice serial reaction time task to the effects of various psychotropic drugs in Sprague-Dawley rats. Biol. Psychiatry 62, 687–693 (2007).
37. Mirza, N.R. & Stolerman, I.P. Nicotine enhances sustained attention in the rat under specific task conditions. Psychopharmacology (Berl.) 138, 266–274 (1998).
38. Robbins, T.W., Muir, J.L., Killcross, A.S. & Pretsell, D. Methods for assessing attention and stimulus control in the rat. In Behavioural Neuroscience: A Practical Approach Vol. I (ed. Sahgal, A.) 13–40 (Oxford University Press, New York, 1993).
39. Parasuraman, R. & Mouloua, M. Interaction of signal discriminability and task type in vigilance decrement. Percept. Psychophys. 41, 17–22 (1987).
40. Grottick, A.J., Haman, M., Wyler, R. & Higgins, G.A. Reversal of a vigilance decrement in the aged rat by subtype-selective nicotinic ligands. Neuropsychopharmacology 28, 880–887 (2003).
41. Robbins, T.W. & Everitt, B.J. Arousal systems and attention. In The Cognitive Neurosciences (ed. Gazzaniga, M.S.) 703–720 (MIT Press, Cambridge, Massachusetts, 1995).
42. Chudasama, Y., Baunez, C. & Robbins, T.W. Functional disconnection of the medial prefrontal cortex and subthalamic nucleus in attentional performance: evidence for corticosubthalamic interaction. J. Neurosci. 23, 5477–5485 (2003).
43. Passetti, F., Dalley, J.W. & Robbins, T.W. Double dissociation of serotonergic and dopaminergic mechanisms on attentional performance using a rodent five-choice reaction time task. Psychopharmacology (Berl.) 165, 136–145 (2003).
44. Bushnell, P.J. Behavioral approaches to the assessment of attention in animals. Psychopharmacology (Berl.) 138, 231–259 (1998).
45. Biederman, J. Attention-deficit/hyperactivity disorder: a selective overview. Biol. Psychiatry 57, 1215–1220 (2005).
46. Laurent, A. et al. Attentional deficits in patients with schizophrenia and in their non-psychotic first-degree relatives. Psychiatry Res. 89, 147–159 (1999).
47. Brown, R.G., Scott, L.C., Bench, C.J. & Dolan, R.J. Cognitive function in depression: its relationship to the presence and severity of intellectual decline. Psychol. Med. 24, 829–847 (1994).
48. Parasuraman, R., Warm, J.S. & See, J.E. Brain systems and vigilance. In The Attentive Brain (ed. Parasuraman, R.) 221–256 (MIT Press, Cambridge, Massachusetts, 1998).
49. Dalley, J.W. et al. Cortical cholinergic function and deficits in visual attentional performance in rats following 192 IgG-saporin-induced lesions of the medial prefrontal cortex. Cereb. Cortex 14, 922–932 (2004).
50. Evenden, J.L. Varieties of impulsivity. Psychopharmacology (Berl.) 146, 348–361 (1999).
51. Christakou, A., Robbins, T.W. & Everitt, B.J. Prefrontal cortical-ventral striatal interactions involved in affective modulation of attentional performance: implications for corticostriatal circuit function. J. Neurosci. 24, 773–780 (2004).
52. Rosner, A.L. & Mittleman, G. Visuospatial attention in the rat and posterior parietal cortex lesions. Behav. Brain Res. 79, 69–77 (1996).
53. Ward, N.M. & Brown, V.J. Covert orienting of attention in the rat and the role of striatal dopamine. J. Neurosci. 16, 3082–3088 (1996).
54. Chudasama, Y. & Robbins, T.W. Dopaminergic modulation of visual attention and working memory in the rodent prefrontal cortex. Neuropsychopharmacology 29, 1628–1636 (2004).
55. Humby, T., Wilkinson, L.S. & Dawson, G.R. Assaying aspects of attention and impulse control in mice using the 5-choice serial reaction time task. In Current

Protocols in Neuroscience (eds. Gerfen, C., Holmes, A., Rogawski, M., Sibley, D., Skolnick, P. & Wray, S.) Unit 8.5H, 8.5H.1–8.5H.15, supplement 31 (John Wiley & Sons, Hoboken, New Jersey, 2005).
56. Weed, M.R. et al. Performance norms for a rhesus monkey neuropsychological testing battery: acquisition and long-term performance. Brain Res. Cogn. Brain Res. 8, 185–201 (1999).
57. Spinelli, S. et al. Performance of the marmoset monkey on computerized tasks of attention and working memory. Brain Res. Cogn. Brain Res. 19, 123–137 (2004).
58. Diergaarde, L. et al. Impulsive choice and impulsive action predict vulnerability to distinct stages of nicotine seeking in rats. Biol. Psychiatry 63, 301–308 (2008).
59. Blondel, A., Sanger, D.J. & Moser, P.C. Characterisation of the effects of nicotine in the five-choice serial reaction time task in rats: antagonist studies. Psychopharmacology (Berl.) 149, 293–305 (2000).
60. Lambourne, S.L. et al. Impairments in impulse control in mice transgenic for the human FTDP-17 tauV337M mutation are exacerbated by age. Hum. Mol. Genet. 16, 1708–1719 (2007).
61. Davies, W., Humby, T., Isles, A.R., Burgoyne, P.S. & Wilkinson, L.S. X-monosomy effects on visuospatial attention in mice: a candidate gene and implications for Turner syndrome and attention deficit hyperactivity disorder. Biol. Psychiatry 61, 1351–1360 (2007).
62. de Senerpont Domis, L.M., Theobald, D.E., Verster, J.C., Dalley, J.W. & Robbins, T.W. Modelling impulsivity in adolescent rats. In Abstract Supplement to Journal of Psychopharmachology (ed. Dursun, S.) Vol. 21 A47 (Summer Meeting of the British Association for Psychopharmachology, Harrogate, UK, 2007).
63. Barnes, P., Staal, V., Muir, J. & Good, M.A. 17-Beta estradiol administration attenuates deficits in sustained and divided attention in young
ovariectomized rats and aged acyclic female rats. Behav. Neurosci. 120, 1225–1234 (2006).
64. Mirza, N.R. & Bright, J.L. Nicotine-induced enhancements in the five-choice serial reaction time task in rats are strain-dependent. Psychopharmacology (Berl.) 154, 8–12 (2001).
65. De Bruin, N.M., Kiliaan, A.J., De Wilde, M.C. & Broersen, L.M. Combined uridine and choline administration improves cognitive deficits in spontaneously hypertensive rats. Neurobiol. Learn. Mem. 80, 63–79 (2003).
66. Cardinal, R.N. & Aitken, M.R.F. Whisker, version 2.2, computer software http://www.whiskercontrol.com (2001).
67. Granon, S. et al. Enhanced and impaired attentional performance after infusion of D1 dopaminergic receptor agents into rat prefrontal cortex. J. Neurosci. 20, 1208–1215 (2000).
68. Winstanley, C.A. et al. Intra-prefrontal 8-OH-DPAT and M100907 improve visuospatial attention and decrease impulsivity on the five-choice serial reaction time task in rats. Psychopharmacology (Berl.) 167, 304–314 (2003).
69. Robbins, T.W. et al. Comparative effects of ibotenic acid- and quisqualic acidinduced lesions of the substantia innominata on attentional function in the rat: further implications for the role of the cholinergic neurons of the nucleus basalis in cognitive processes. Behav. Brain Res. 35, 221–240 (1989).
70. Muir, J.L., Everitt, B.J. & Robbins, T.W. AMPA-induced excitotoxic lesions of the basal forebrain: a significant role for the cortical cholinergic system in attentional function. J. Neurosci. 14, 2313–2326 (1994).
71. Cole, B.J. & Robbins, T.W. Forebrain norepinephrine: role in controlled information processing in the rat. Neuropsychopharmacology 7, 129–142 (1992).
72. Dalley, J.W., Cardinal, R.N. & Robbins, T.W. Prefrontal executive and cognitive functions in rodents: neural and neurochemical substrates. Neurosci. Biobehav. Rev. 28, 771–784.

### puor G

### gni hsil buP

### er ut a N8002 © natureprotocols / moc. er ut an. w

w
w//: ptt h
