M-F-Soares/5-CSRTT/PCB/placa_casinhas.pdf

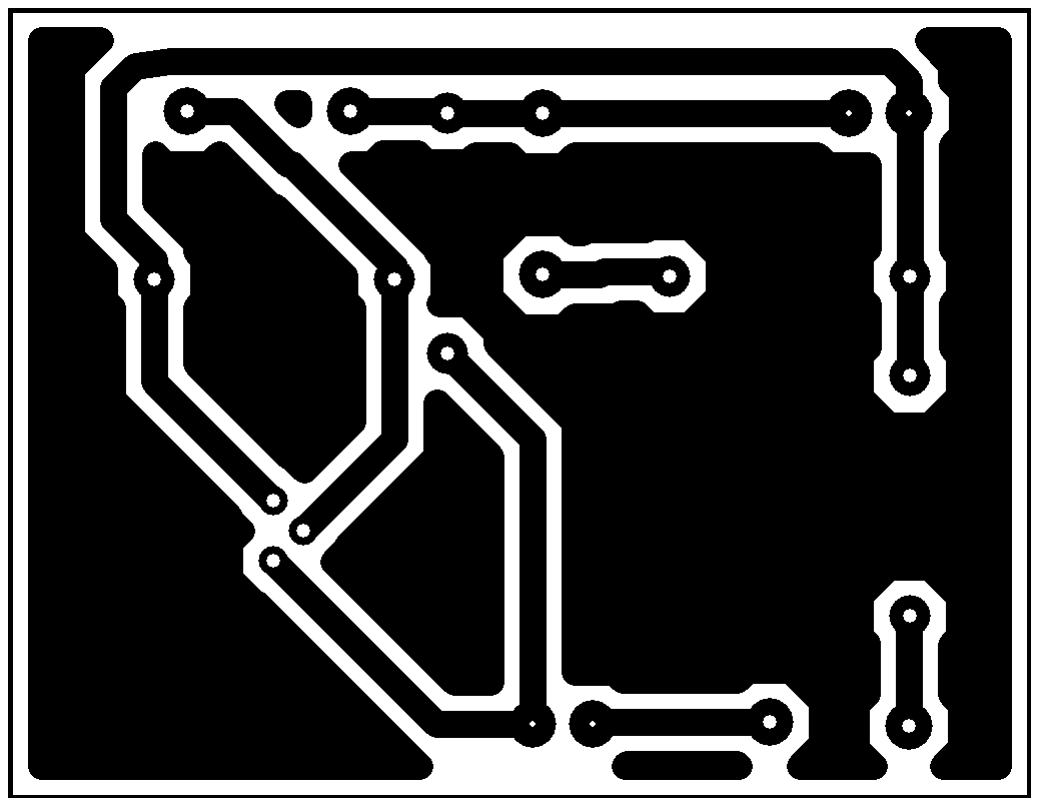
[picture p9: figure]
