M-F-Soares/5-CSRTT/PCB/casinhas.bmp

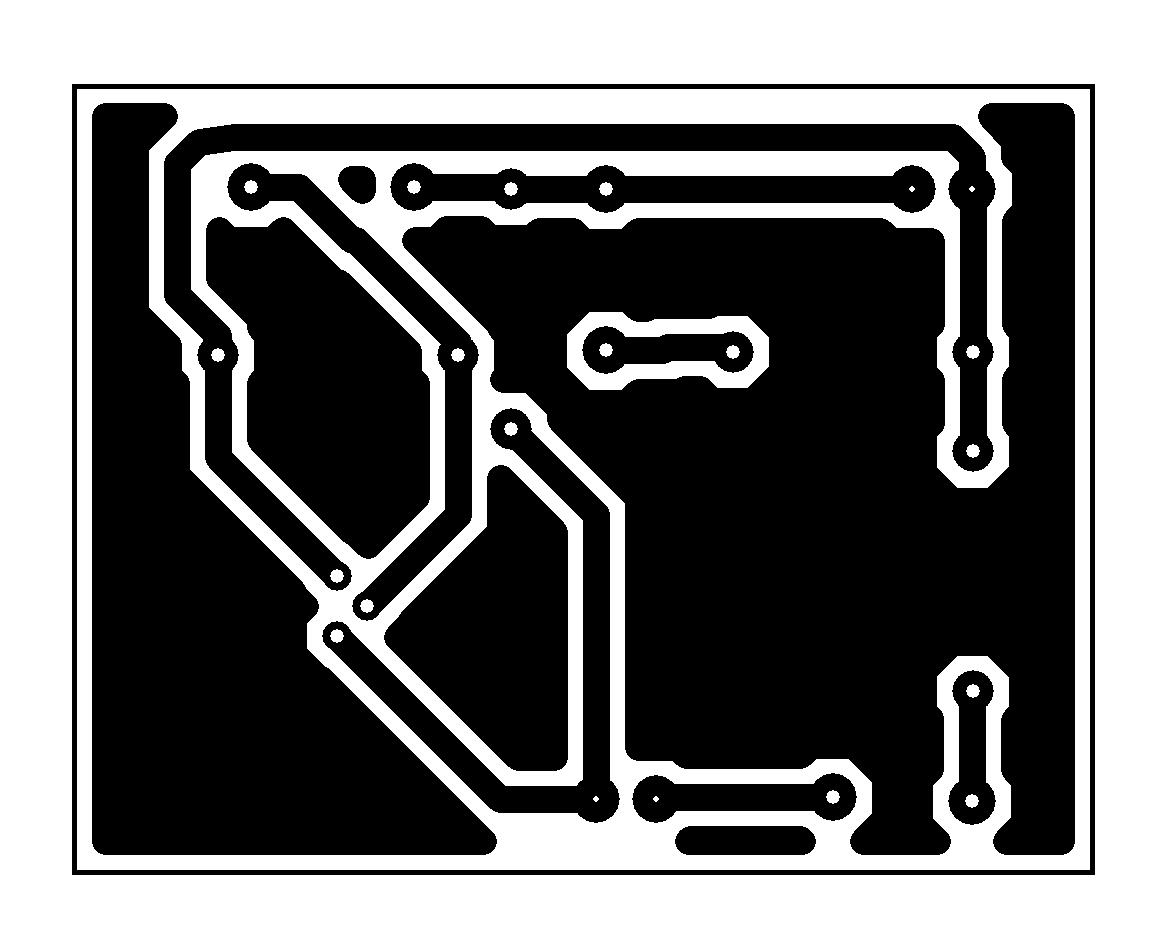
PCB/casinhas.bmp
