M-F-Soares/5-CSRTT/Desenhos/Alimentador/caixa.SLDPRT

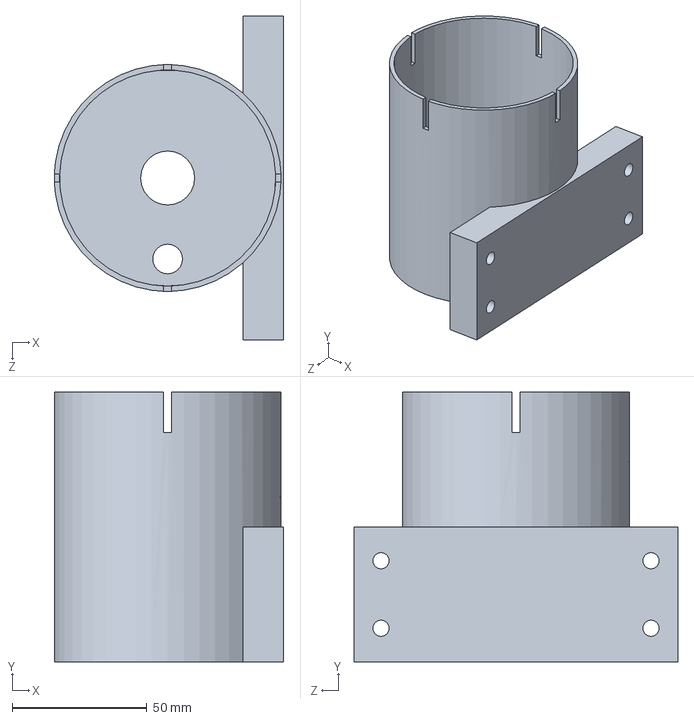
[picture p11: CAD file, 2021-06-11]
Desenhos/Alimentador/caixa.SLDPRT
85.0 x 100.0 x 120.0 mm
