M-F-Soares/5-CSRTT/Desenhos/Alimentador/Disco1.SLDPRT

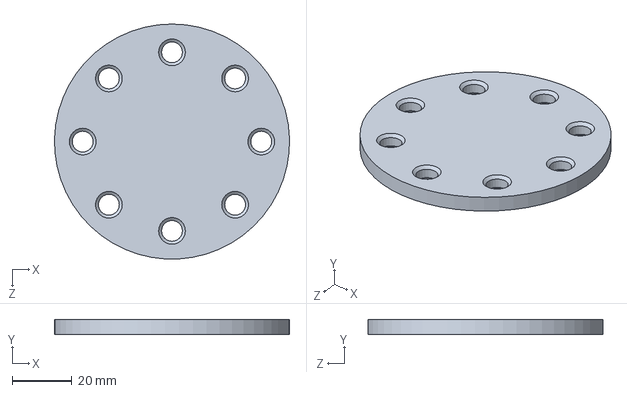
[picture p12: CAD file, 2021-06-11]
Desenhos/Alimentador/Disco1.SLDPRT
79.0 x 5.00 x 78.9 mm
