M-F-Soares/5-CSRTT/Desenhos/Alimentador/camara_alimentador.SLDPRT

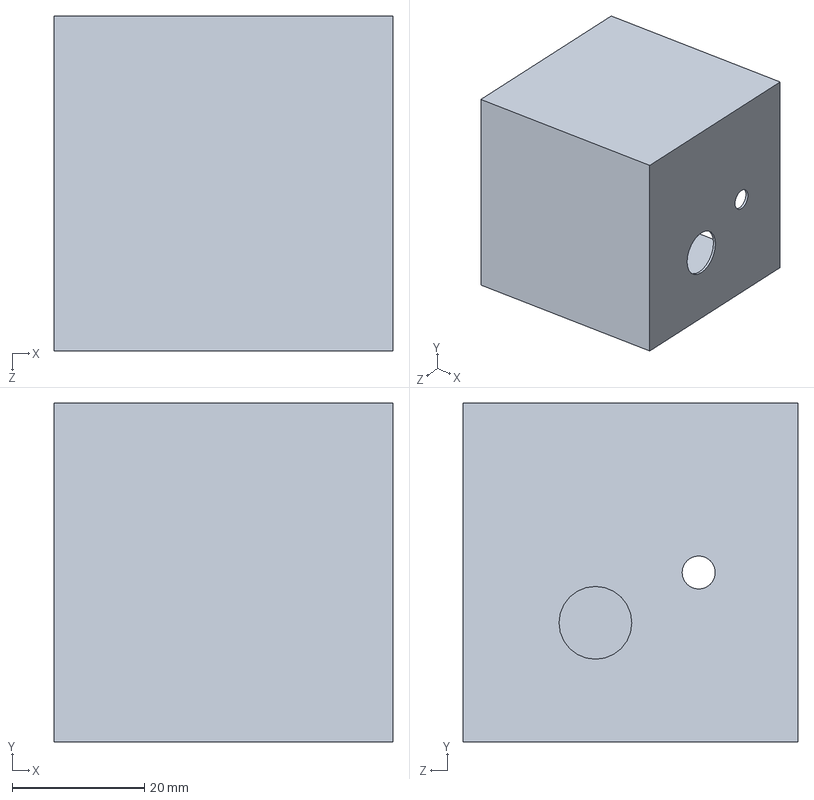
[picture p13: CAD file, 2021-06-11]
Desenhos/Alimentador/camara_alimentador.SLDPRT
51.2 x 51.2 x 50.6 mm
