M-F-Soares/5-CSRTT/Desenhos/Alimentador/camada_ABS_alimentador.SLDPRT

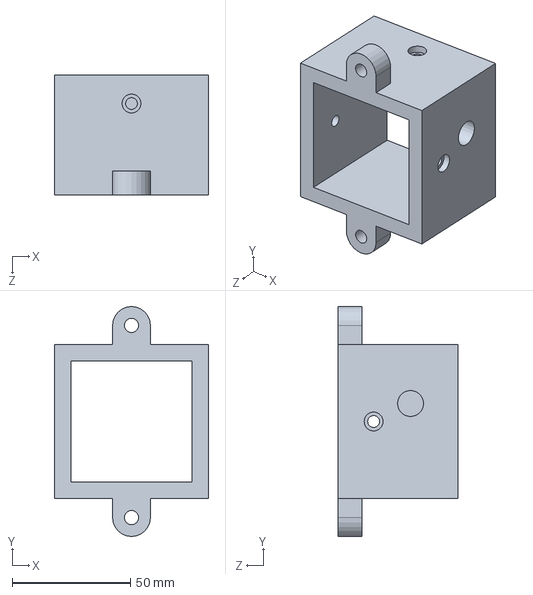
[picture p14: CAD file, 2021-06-11]
Desenhos/Alimentador/camada_ABS_alimentador.SLDPRT
65.2 x 97.2 x 50.6 mm
