M-F-Soares/5-CSRTT/(list of files, cad)

Other CAD files:
Desenhos/Alimentador/Disco.STEP
Desenhos/Alimentador/Disco.SLDPRT
Desenhos/Alimentador/Disco1.STL
Desenhos/Alimentador/caixa.STL
Desenhos/Alimentador/camada_ABS_alimentador.STL
