M-F-Soares/5-CSRTT/(list of files, drawings)

Other design files:
PCB/testao.pdsprj
