M-F-Soares/5-CSRTT/Arduino/config.h

#ifndef CONFIG
#define CONFIG

const int pinoBotao = 16;
const int ledAlimentador = 15;
const int altobrilho = 50;
const int buzzer = 2;
const int receptor_alimentador = 14;



// Variáveis de configuração

const int controle_buzzer = 1000;
const int tempo_punicao = 1000;
const int tempo_espera = 2000;

#endif
